kcaluwae/tensegrity-powerboard/README.md

tensegrity-powerboard
=====================

pcb design for the SUPERball power board
