kcaluwae/tensegrity-powerboard/(commit log)

2013-12-15 Schematics for both DC/DC converters should be OK
    [superball_powerboard.sch]
2013-12-16 almost done with the schematic. still need to add the connectors and the 5.5V gate drivers.
    [superball_powerboard.sch]
2013-12-17 schematic is semi-finished. Needs some cleanup
    [superball_powerboard.sch]
2013-12-20 finished schematic
    [superball_powerboard.sch]
2013-12-22 finished schematic, started pcb layout
    [superball_powerboard.kicad_pcb, superball_powerboard.sch]
2013-12-22 connected VMOTOR_EN to pin of uC
    [superball_powerboard.sch]
2013-12-23 started organizing the pcb layout
    [superball_powerboard.kicad_pcb]
2013-12-25 did initial placement of the components on the pcb
    [superball_powerboard.kicad_pcb, superball_powerboard.sch]
2013-12-26 fixed a few bugs in the schematic and started preliminary routing
    [superball_powerboard.kicad_pcb, superball_powerboard.sch]
2013-12-28 finished routing (preliminary). Added a current sensor for the 5.5V line.
    [superball_powerboard.kicad_pcb, superball_powerboard.sch]
2013-12-28 cleaned up traces, added test pins etc
    [superball_powerboard.kicad_pcb, superball_powerboard.sch]
2013-12-29 silkscreen layout
    [superball_powerboard.kicad_pcb]
2013-12-31 made a new revision with PMOS transistors for high side 5.5V output switches
    [superball_powerboard_pmos.kicad_pcb, superball_powerboard_pmos.sch]
2014-01-05 cleaned up a few traces
    [superball_powerboard.kicad_pcb]
2014-01-09 Cleaned up the CAN Trans. Traces.
    [superball_powerboard_pmos.kicad_pcb]
2014-01-10 changed some things....
    [superball_powerboard_pmos.kicad_pcb]
2014-01-10 cleaned up traces and fixed a few minor issues (hole positions)
    [superball_powerboard_pmos.kicad_pcb]
2014-01-10 Added Gerber files. Changed mounting holes to match motor board.
    [superball_powerboard_pmos-B_Cu.gbl, superball_powerboard_pmos-B_SilkS.gbo, superball_powerboard_pmos-Edge_Cuts.gbr, superball_powerboard_pmos-F_Cu.gtl, superball_powerboard_pmos-F_SilkS.gto, superball_powerboard_pmos-Inner1_Cu.gbr, superball_powerboard_pmos-Inner2_Cu.gbr, superball_powerboard_pmos.drl]
2014-01-10 Minor changes to layout.
    [superball_powerboard_pmos.kicad_pcb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]
2014-01-10 forget to move a resistor
    [superball_powerboard_pmos.kicad_pcb]
2014-01-10 Made gerber files from last commit.
    [superball_powerboard_pmos-B_Cu.gbl, superball_powerboard_pmos-B_SilkS.gbo, superball_powerboard_pmos-Edge_Cuts.gbr, superball_powerboard_pmos-F_Cu.gtl, superball_powerboard_pmos-F_SilkS.gto, superball_powerboard_pmos-Inner1_Cu.gbr, superball_powerboard_pmos-Inner2_Cu.gbr, superball_powerboard_pmos.drl]
2014-01-10 Forgot to save the layout from last push.
    [superball_powerboard_pmos.kicad_pcb]
2014-01-10 Changed the silkscreen to be less messy.
    [superball_powerboard_pmos-B_Cu.gbl, superball_powerboard_pmos-B_SilkS.gbo, superball_powerboard_pmos-Edge_Cuts.gbr, superball_powerboard_pmos-F_Cu.gtl, superball_powerboard_pmos-F_SilkS.gto, superball_powerboard_pmos-Inner1_Cu.gbr, superball_powerboard_pmos-Inner2_Cu.gbr]
2014-01-10 Forgot to save the kicad_pcb file... again.
    [superball_powerboard_pmos.kicad_pcb]
2014-01-11 Cleaning up gerber files.
    [superball_powerboard_pmos.kicad_pcb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]
2014-01-13 Added the Front and Back Solder mask gerber files.
    [superball_powerboard_pmos-B_Mask.gbs, superball_powerboard_pmos-F_Mask.gts]
2014-01-31 Commit of the gerber files used in fabrication.
    [superball_powerboard.sch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]
2014-05-07 designed test pcbs for boost converter
    [LM3481_sch.sch, LTC1871_sch.sch, lm3481_ltc1871_eval.kicad_pcb, ltc1871_eval.kicad_pcb, noname.sch, superball_powerboard_pmos.kicad_pcb, superball_powerboard_pmos.sch]
2014-05-09 cleaned up schematic and fixed some issues
    [ltc1871_eval-append.kicad_pcb, superball_powerboard_pmos.sch]
2014-05-11 updated power board schematic (new RF transceiver, updated kill switch circuit, watchdog, buzzer, buttons)
    [lm3481_ltc1871_eval.kicad_pcb, ltc1871_eval.kicad_pcb, superball_powerboard_pmos.kicad_pcb, superball_powerboard_pmos.sch]
2014-05-23 upgraded to kicad r4885 and almost finished revised powerboard schematic
    [noname.sch, superball_powerboard_pmos.sch]
2014-05-24 finished revised schematic
    [LTC1871_sch.sch, superball_powerboard_pmos.sch]
2014-05-27 partial layout of v2
    [superball_powerboard_pmos.kicad_pcb, superball_powerboard_pmos.sch]
2014-05-28 halfway done with routing powerboard v2
    [superball_powerboard_pmos.kicad_pcb, superball_powerboard_pmos.sch]
2014-06-07 95% done (revised powerboard)
    [superball_powerboard_pmos.kicad_pcb, superball_powerboard_pmos.sch]
2014-06-08 finished layout of revised powerboard
    [superball_powerboard_pmos.kicad_pcb]
2014-08-11 Refilled the power and ground plane pours. Fixed the issue on U8 by changing R41 to 5V5_VBACKUP from 5V5_VBAT
    [superball_powerboard_pmos.kicad_pcb, superball_powerboard_pmos.sch]
2014-08-12 Fixed the pin out on the microclasp connectors. They where all flipped from the standard.
    [superball_powerboard_pmos.kicad_pcb, superball_powerboard_pmos.sch]
